hyperlode/alarm_clock/Gravity-I2C-SD2405-RTC-Module-master/README.md

# Gravity I2C SD2405 RTC Module

Gravity I2C SD2405 RTC Module Respository, including library, sample code, Schematic & layout<br>

Contains the Following:

* Arduino library: GravityRtc
* Arduino library.zip: GravityRtc.zip
* Schematic.pdf: Gravity I2C SD2405 RTC Module Schematic.pdf
* Layout.pdf: Gravity I2C SD2405 RTC Module Layout.pdf
* Datasheet: SD2405AL datasheet.pdf

[Get the RTC Module here](https://www.dfrobot.com/wiki/index.php/Gravity:_I2C_SD2405_RTC_Module_SKU:_DFR0469)

# To Download, please click "Clone & Download ZIP"
