hyperlode/alarm_clock/demo fancy mirrored display clock.png

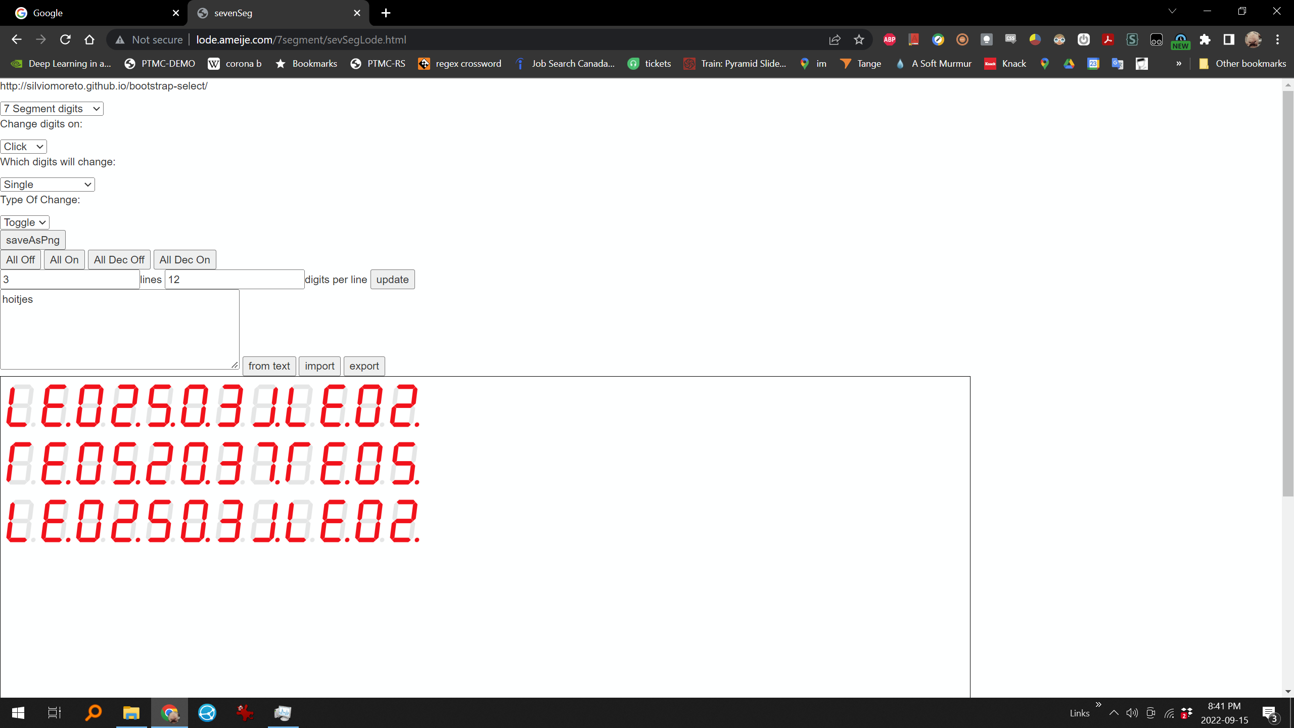
demo fancy mirrored display clock.png
