hyperlode/alarm_clock/pcb/components/3d_models/4-digit-7segment-display.step

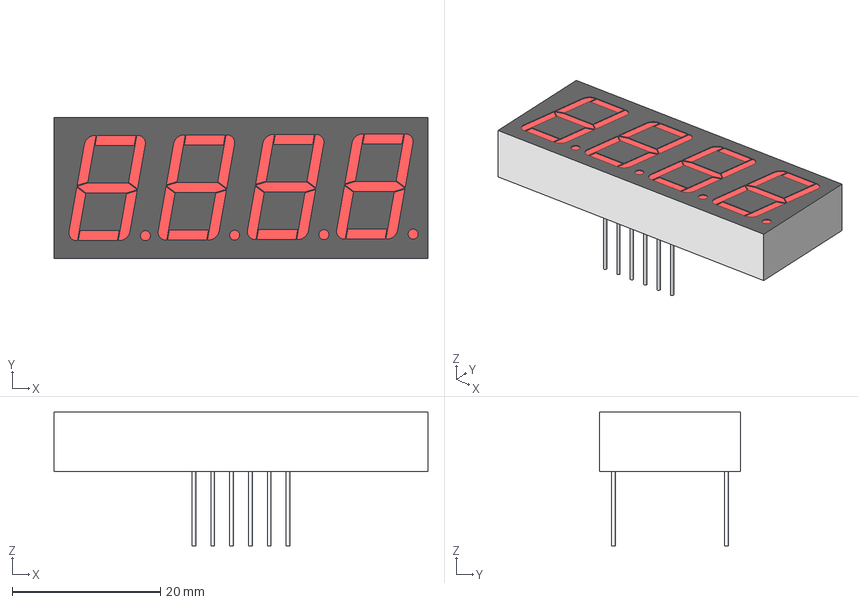
[picture p2: CAD file, 2022-10-23]
pcb/components/3d_models/4-digit-7segment-display.step
50.4 x 19.0 x 18.0 mm
