hyperlode/alarm_clock/pcb/components/3d_models/7segment_4digits.scad

translate([8.5,25,-1]){
cube([19,50,8],true);
}
translate([8.5,25,-1]){
    cube([2.5,2.5,1]);
}
