hyperlode/alarm_clock/(list of files, cad)

Other CAD files:
pcb/components/3d_models/4-digit-7segment-display.FCStd
