hyperlode/alarm_clock/pcb/digital_clock_v3/digital_clock_v3.kicad_pcb

## KiCad design pcb/digital_clock_v3/digital_clock_v3.kicad_pcb (2023-07-28)

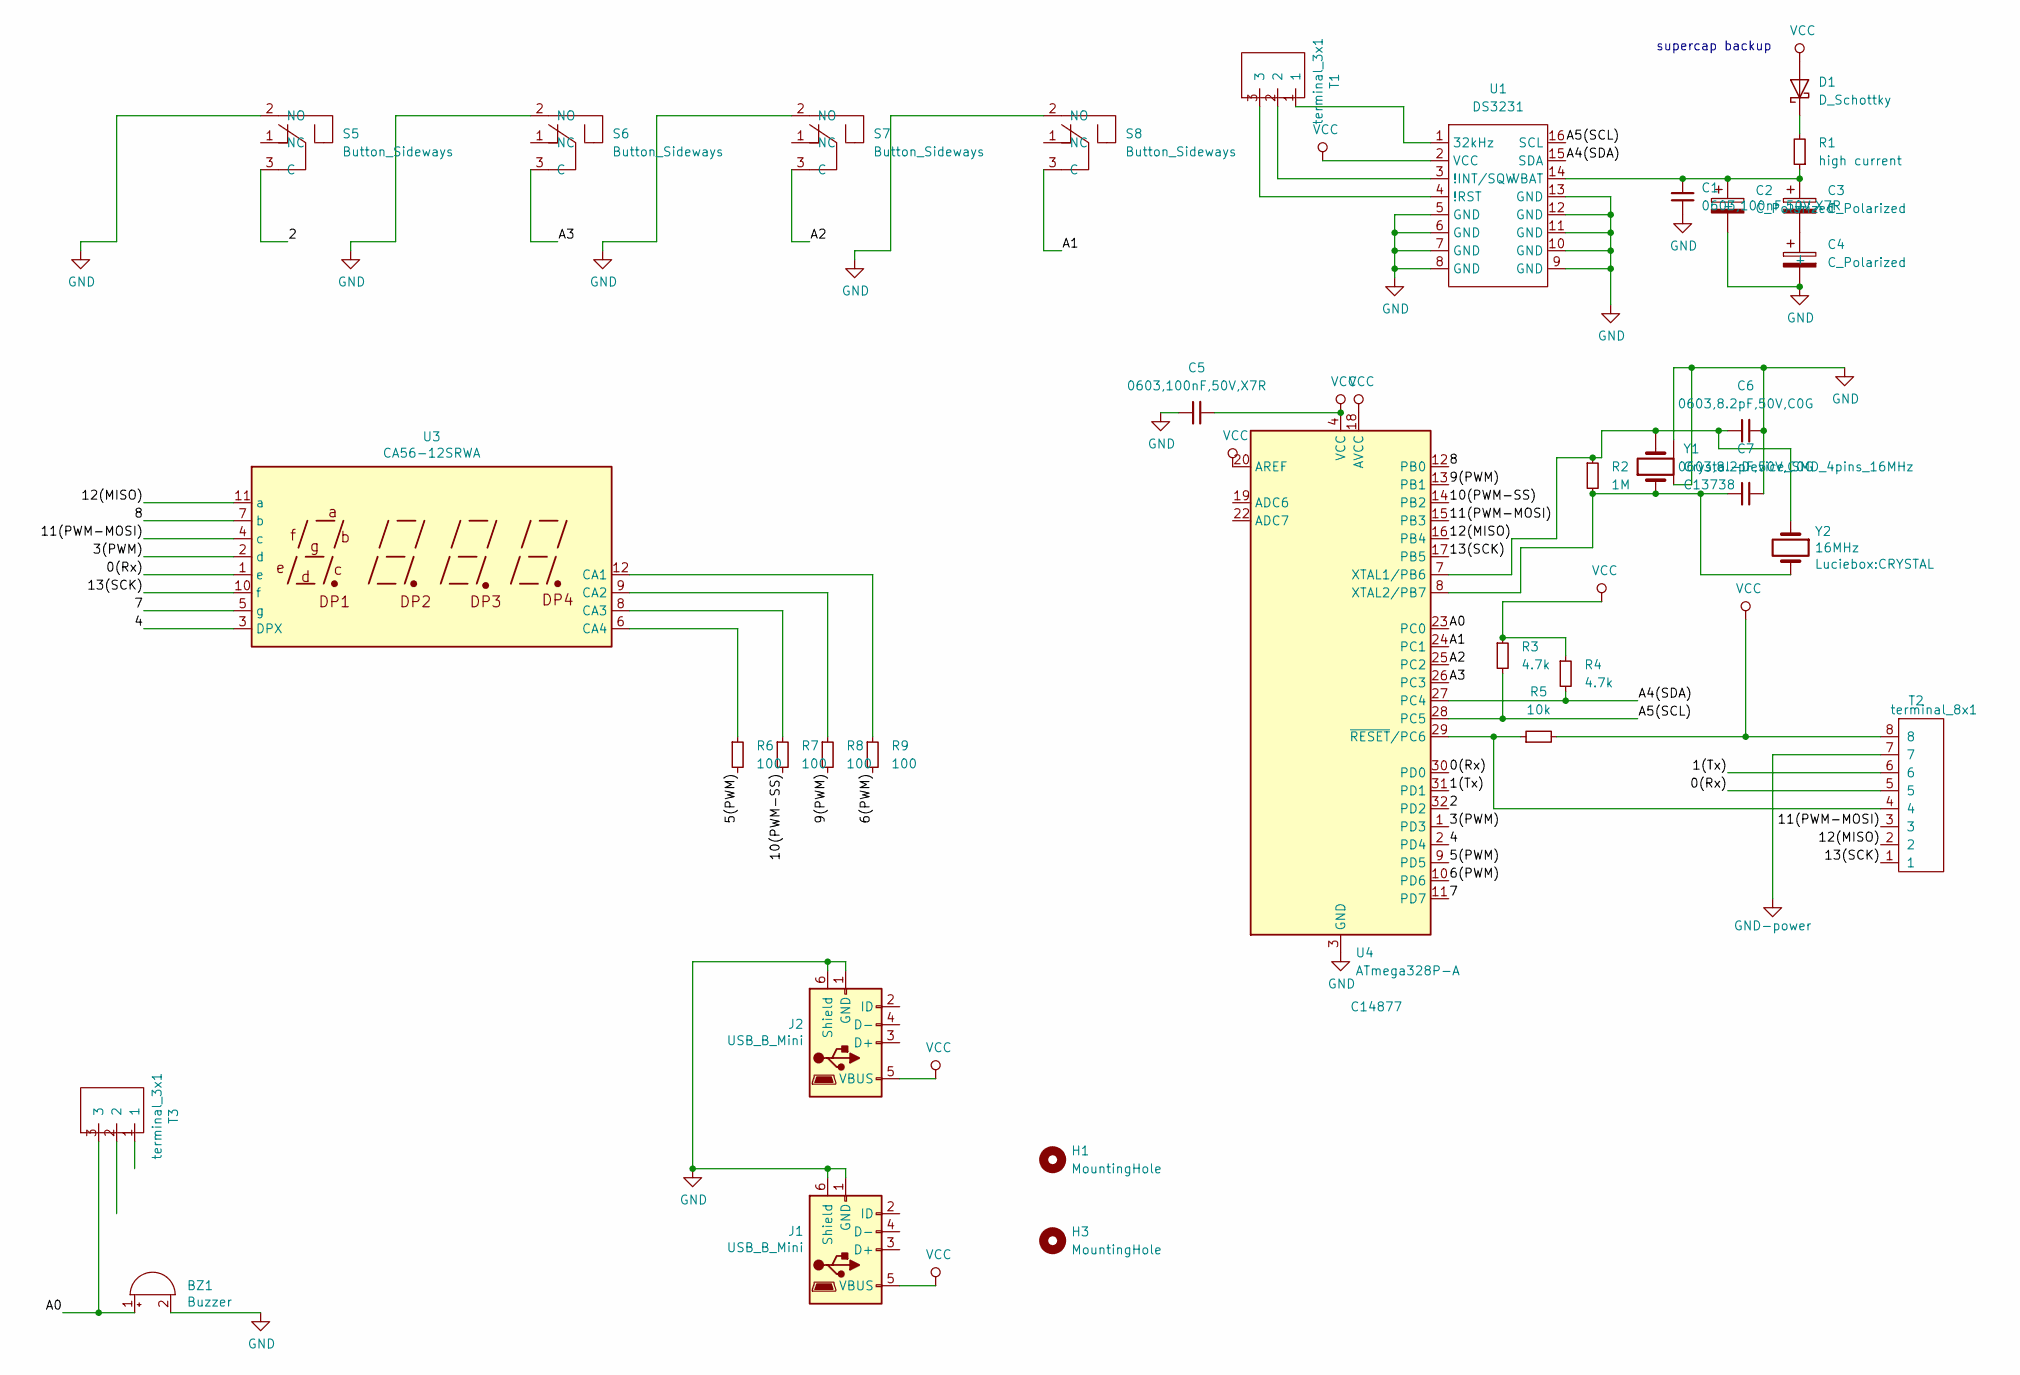
[picture p3: schematic digital_clock_v3.kicad_sch]

Parts:
BZ1: Buzzer; buzzer
C1, C5: 0603,100nF,50V,X7R; C_0603_1608Metric; MFGPN CC0603KRX7R9BB104; LCSC C14663
C2, C3, C4: C_Polarized; polarized_capacitor
C6, C7: 0603,8.2pF,50V,C0G; C_0603_1608Metric; MFGPN 0603CG8R2C500NT; LCSC C1685
D1: D_Schottky; smd_throughhole_2_pins
H1, H3: MountingHole; MountingHole_4.3mm_M4
J1, J2: USB_B_Mini; usb_mini_Molex-0548190519
R1: high current; R_0603_1608Metric; MFGPN 0603WAF1004T5E; LCSC C22935
R2: 1M; R_0603_1608Metric; MFGPN 0603WAF1004T5E; LCSC C22935
R3, R4: 4.7k; R_0603_1608Metric; MFGPN 0603WAF4701T5E; LCSC C23162
R5: 10k; R_0603_1608Metric; MFGPN 0603WAF1002T5E; LCSC C25804
R6, R7, R8, R9: 100; R_0402_1005Metric; MFGPN 0402WGF1000TCE; LCSC C25076
S5, S6, S7, S8: Button_Sideways; Button_LAZ16-11_sideways; MPN KS-01Q-01; Digi-Key_PN EG4791-ND
T1, T3: terminal_3x1; Terminal_3x1_100mil
T2: terminal_8x1; Terminal_8x1_100mil
U1: DS3231; SOIC-16W_7.5x10.3mm_P1.27mm
U3: CA56-12SRWA
U4: ATmega328P-A; TQFP-32_7x7mm_P0.8mm; LCSC C14877
Y1: Crystal-Device_SMD_4pins_16MHz; Crystal_SMD_3225-4Pin_3.2x2.5mm; JLCS C13738
Y2: 16MHz; CRYSTAL

Connections:
/0(Rx): T2.5, U3.1 (e), U4.30 (PD0)
/1(Tx): T2.6, U4.31 (PD1)
/2: S5.3 (C), U4.32 (PD2)
/3(PWM): U3.2 (d), U4.1 (PD3)
/4: U3.3 (DPX), U4.2 (PD4)
/5(PWM): R6.2, U4.9 (PD5)
/6(PWM): R9.2, U4.10 (PD6)
/7: U3.5 (g), U4.11 (PD7)
/8: U3.7 (b), U4.12 (PB0)
/9(PWM): R8.2, U4.13 (PB1)
/10(PWM-SS): R7.2, U4.14 (PB2)
/11(PWM-MOSI): T2.3, U3.4 (c), U4.15 (PB3)
/12(MISO): T2.2, U3.11 (a), U4.16 (PB4)
/13(SCK): T2.1, U3.10 (f), U4.17 (PB5)
/A0: BZ1.1 (-), T3.3, U4.23 (PC0)
/A1: S8.3 (C), U4.24 (PC1)
/A2: S7.3 (C), U4.25 (PC2)
/A3: S6.3 (C), U4.26 (PC3)
/A4(SDA): R4.2, U1.15 (SDA), U4.27 (PC4)
/A5(SCL): R3.2, U1.16 (SCL), U4.28 (PC5)
unnamed: C1.2, C2.1 (+), C3.1 (+), R1.1, U1.14 (VBAT)
unnamed: C3.2 (-), C4.1 (+)
unnamed: C6.1, R2.1, U4.7 (XTAL1/PB6), Y1.3 (OSC2), Y2.1
unnamed: C7.1, R2.2, U4.8 (XTAL2/PB7), Y1.1 (OSC1), Y2.2
unnamed: D1.1 (K), R1.2
unnamed: R5.1, T2.4, U4.29 (~RESET/PC6)
unnamed: R6.1, U3.6 (CA4)
unnamed: R7.1, U3.8 (CA3)
unnamed: R8.1, U3.9 (CA2)
unnamed: R9.1, U3.12 (CA1)
unnamed: T1.1, U1.1 (32kHz)
unnamed: T1.2, U1.3 (!INT/SQW)
unnamed: T1.3, U1.4 (!RST)
VCC: C5.2, D1.2 (A), J1.5 (VBUS), J2.5 (VBUS), R3.1, R4.1, R5.2, T2.8, U1.2 (VCC), U4.4 (VCC), U4.6 (VCC), U4.18 (AVCC), U4.20 (AREF)

Notes on the sheet:
supercap backup

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
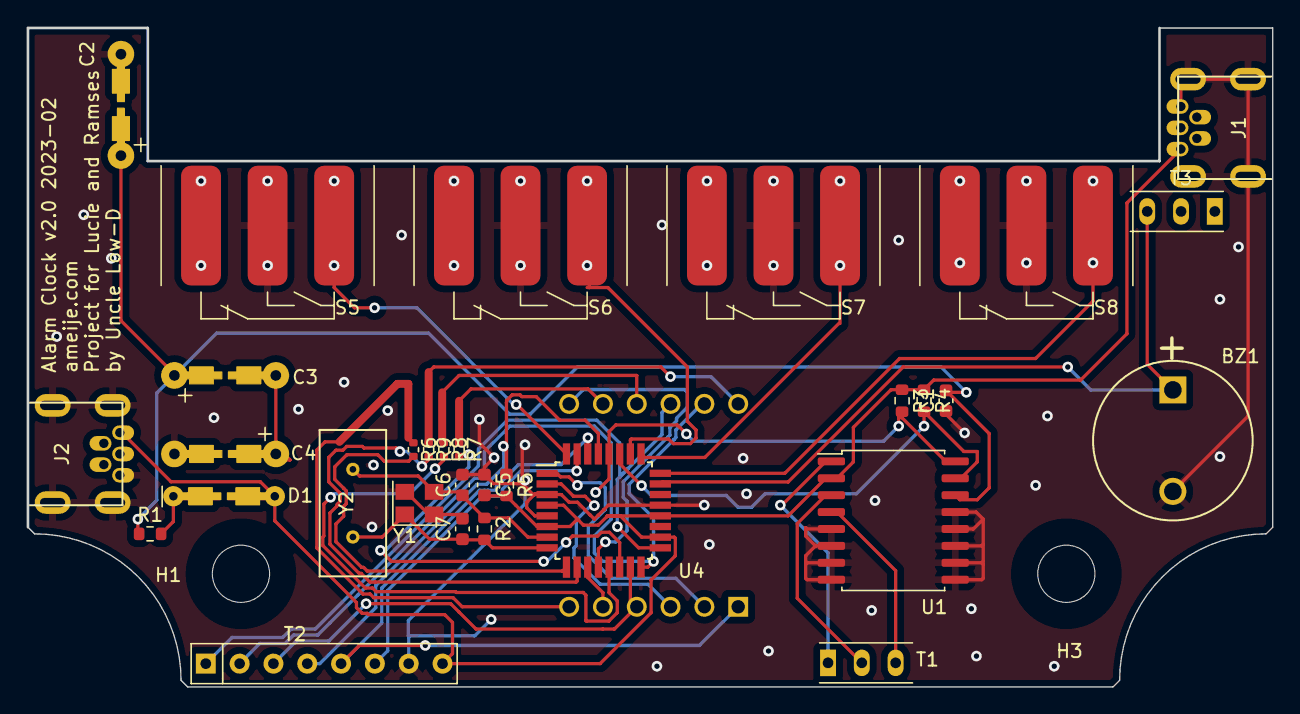
[picture p4: board digital_clock_v3.kicad_pcb from above]

Board: 2 copper layers, 93.5 x 49.5 mm, 34 parts (1 on the bottom side), 35 nets.
