hyperlode/alarm_clock/(commit log)

2022-09-04 Clock demo working and added a button
2022-09-04 Button as separate class
2022-09-04 Use momentary button as toggle button
2022-09-05 Make display dimmable with pwm
2022-09-06 Add two more buttons, three in total
2022-09-07 midnight minutes display bugfix
    [arduino_uno_digital_clock.ino]
2022-09-09 Set and adjust alarm time. No buzzer yet
    [arduino_uno_digital_clock.ino]
2022-09-09 Blink resistant value changing during time setting
2022-09-09 Implement buzzer, but tone at line114 of buzzer.cpp is giving trouble (try it in dimmed mode) things crash.
    [Buzzer.cpp, Buzzer.h, arduino_uno_digital_clock.ino]
2022-09-11 PWM no interference with tone. Swapped pins. Sound test
    [arduino_uno_digital_clock.ino]
2022-09-11 Alarm clock functioning (alarm time not retentive at power off)
2022-09-11 bugfix crash at serial.println during alarm AT time setting
    [arduino_uno_digital_clock.ino]
2022-09-14 Bugfix vibrating minutes:seconds display
    [arduino_uno_digital_clock.ino]
2022-09-14 rtc memory readout (doesn't really seem to work), update display timeouts
    [GravityRtc.cpp, GravityRtc.h, arduino_uno_digital_clock.ino]
2022-09-20 Bugfix alarm set dot display after dark mode
    [arduino_uno_digital_clock.ino]
2022-09-21 Add extra button
2022-09-23 Start adding kitchen timer, debug serial
2022-09-23 optimize kitchen timer
2022-09-24 Kitchen timer improvement
2022-09-24 Change alarm enable toggle button
2022-09-25 Save kitchen timer state to eeprom
2022-09-25 Kitchen timer reset bugfix
    [arduino_uno_digital_clock.ino]
2022-09-26 Enable long pressing buttons
2022-09-26 Kitchen timer blink settings
2022-10-10 Long press for timer. long press period setting
2022-10-13 Snooze indicator dot behaviour bugfix
    [arduino_uno_digital_clock.ino]
2022-10-14 Rework button positions
2022-10-15 Bugfix long press button behaviour
    [Button.cpp, Button.h, arduino_uno_digital_clock.ino]
2022-10-15 Swap button positions
2022-10-15 Alarm status and snooze status saved in eeprom. You know, for pre flight sleep power cuts!
2022-10-15 Buttons change function when alarm triggers (they become snooze buttons)
2022-10-17 Decreasing snooze bug fix
    [arduino_uno_digital_clock.ino]
2022-10-17 Bugfix change time while kitchen timer running
    [arduino_uno_digital_clock.ino]
2022-10-20 Add pcb schematic and start of layout
    [digital_clock_v1.kicad_pcb, digital_clock_v1.kicad_sch]
2022-10-23 Add pcb design, not yet ready
    [4-digit-7segment-display.FCStd, 4-digit-7segment-display.step, 7segment_4digits.scad, digital_clock_v1.kicad_pcb, digital_clock_v1.kicad_sch, led_display_7segment_4digits.scad]
2022-10-28 Bugfix alarm sounds. Play alarm sounds in menu
    [arduino_uno_digital_clock.ino]
2022-11-01 Brightness, ditch PWM. Stable, but bad with dimming of course
2022-11-14 PCB Send out v1
    [digital_clock_v1-B_Cu.gbr, digital_clock_v1-B_Mask.gbr, digital_clock_v1-B_Paste.gbr, digital_clock_v1-B_Silkscreen.gbr, digital_clock_v1-Edge_Cuts.gbr, digital_clock_v1-F_Cu.gbr, digital_clock_v1-F_Mask.gbr, digital_clock_v1-F_Paste.gbr]
2022-11-21 Ditch PWM for multiplexing. Change multiplex to per digit instead of per segment. Good results
2022-12-03 Swap pins for the v1 pcb
    [arduino_uno_digital_clock.ino]
2022-12-03 Kitchen timer save to eeprom at timer start
2023-02-06 v2 pcb create. No traces yet.
    [digital_clock_v2.kicad_pcb, digital_clock_v2.kicad_sch]
2023-02-06 Finish v2 pcb wiring
    [digital_clock_v2.kicad_pcb, digital_clock_v2.kicad_sch]
2023-02-06 Correct button positions
    [digital_clock_v2.kicad_pcb, digital_clock_v2.kicad_sch]
2023-02-16 Add v2 pcb. Code clean up
    [digital_clock_v2.kicad_pcb]
2023-02-18 Set brightness levels. Fix instant start/stop bug at longpress for kitchentimer
    [Button.cpp, Button.h, LedMultiplexer5x8.cpp, LedMultiplexer5x8.h, arduino_uno_digital_clock.ino]
2023-02-20 Protection against millis rollover
2023-02-20 Add more millis rollover protection
2023-02-20 Fix more millis rollover bugs
    [Button.cpp, Buzzer.cpp, Buzzer.h, arduino_uno_digital_clock.ino]
2023-02-21 Bugfix long press not smooth for kitchen timer
    [Button.cpp, Button.h, arduino_uno_digital_clock.ino]
2023-03-02 Fix bug: unsigned long casting
    [arduino_uno_digital_clock.ino]
2023-04-18 pcb and enclosure
2023-04-18 Alarm minutes settable without crashing. Bug not reproducable after reuploading...
    [arduino_uno_digital_clock.ino]
2023-06-19 Improve kitchen timer behaviour. Long press time extend
2023-07-28 Create v3 pcb
    [digital_clock_v2-B_Cu.gbr, digital_clock_v2-B_Mask.gbr, digital_clock_v2-B_Paste.gbr, digital_clock_v2-B_Silkscreen.gbr, digital_clock_v2-Edge_Cuts.gbr, digital_clock_v2-F_Cu.gbr, digital_clock_v2-F_Mask.gbr, digital_clock_v2-F_Paste.gbr]
