hyperlode/alarm_clock/(notices)

Notices in the files:
arduino_uno_digital_clock/GravityRtc.cpp:
Copyright (C) 2017 [DFRobot](http://www.dfrobot.com),
GitHub Link :https://github.com/DFRobot/Gravity-I2C-SD2405-RTC-Module
